salex1210/Project_Electronic_System_Design_B1/Capturas/MAP001.BMP

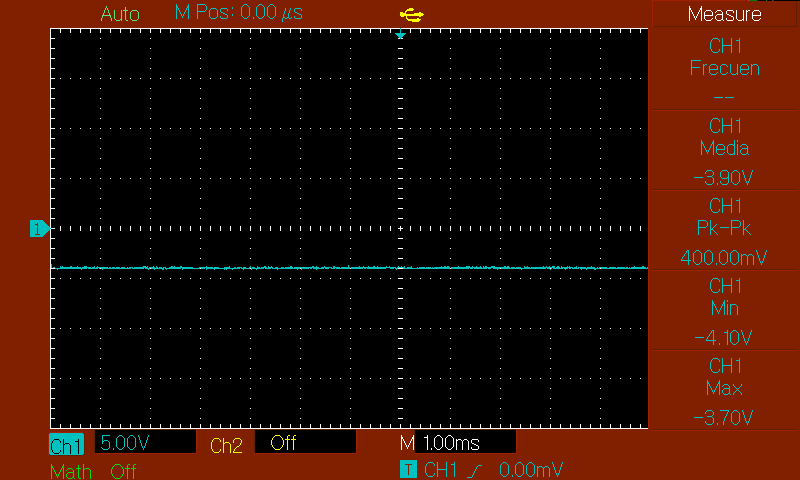
Capturas/MAP001.BMP
