salex1210/Project_Electronic_System_Design_B1/Capturas/MAP004.BMP

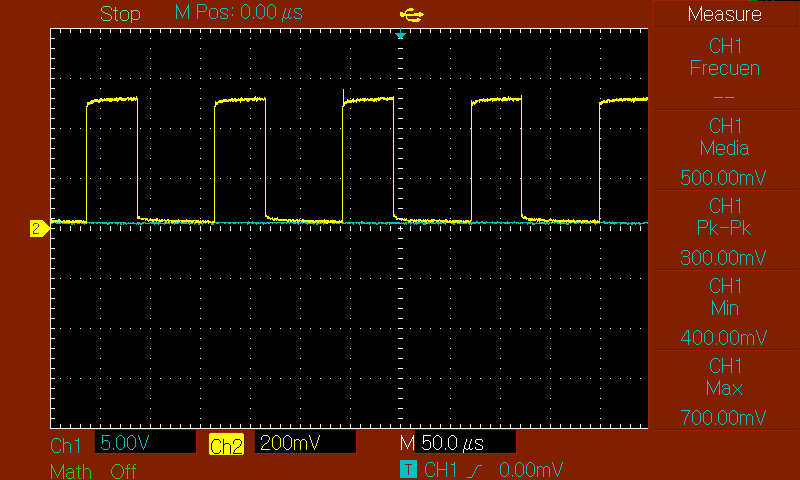
Capturas/MAP004.BMP
