salex1210/Project_Electronic_System_Design_B1/Capturas/MAP005.BMP

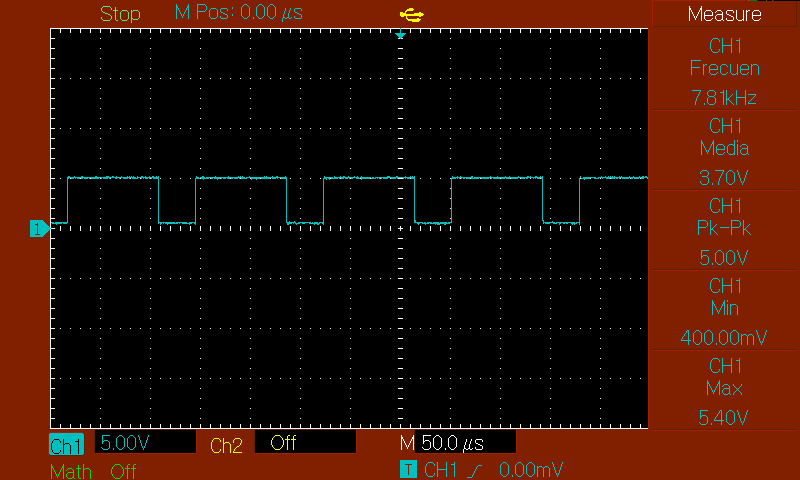
Capturas/MAP005.BMP
