salex1210/Project_Electronic_System_Design_B1/CuentasProyecto.xlsx

Sheet: Hoja1
 | Presupuesto Proyecto
 | Elemento | Unidades | Utilizados | Precio U. | Total Utilizados | Total Proyecto | Link
 | LTC2644IMS-L12#PBF | 2 | 1 | $33272.00 | $33272.00 | $66544.00 | https://co.mouser.com/ProductDetail/Analog-Devices/LTC2644IMS-L12PBF?qs=hVkxg5c3xu%252BwxghzaVh9wg%3D%3D
 | MAX1044/ICL7660 | 1 | 1 | $22045.00 | $22045.00 | $22045.00 | https://co.mouser.com/ProductDetail/Analog-Devices-Maxim-Integrated/MAX1044CPA%2b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
 | TL081HIDR | 4 | 2 | $1327.00 | $2654.00 | $5308.00 | https://co.mouser.com/ProductDetail/Texas-Instruments/TL081HIDR?qs=pBJMDPsKWf2IEA%252Bv86wIaw%3D%3D
 | Capacitor 0.1 uf X7R ceramico | 6 | 5 | $1633.00 | $8165.00 | $9798.00 | https://co.mouser.com/ProductDetail/KYOCERA-AVX/KAM21BR71H104JT?qs=Jm2GQyTW%2Fbic6Zk4McEt6w%3D%3D | https://co.mouser.com/ProductDetail/Vishay-Sprague/293D106X0016B2TE3
 | Capacitor 100 uf X7R | 4 | 2 | $2143.00 | $4286.00 | $8572.00 | https://co.mouser.com/ProductDetail/Vishay-Sprague/TR3B106K025C1300 | https://co.mouser.com/ProductDetail/TAIYO-YUDEN/EMK212BB7106KG-T
 | Header 1x2 | 5 | 4 | $2000.00 | $8000.00 | $10000.00
 | Jumper Cap | 5 | 4 | $1000.00 | $4000.00 | $5000.00
Bornera | Phoenix Contact 1729128 | 3 | 2 | $5000.00 | $10000.00 | $15000.00
 |  | 0 | 0 | $5000.00 | $0.00 | $0.00
 |  | 0 | 0 | $5000.00 | $0.00 | $0.00
 |  | 0 | 0 | $5000.00 | $0.00 | $0.00
 | Total |  |  |  | $92422.00 | $142267.00
 |  |  |  |  | $23105.50 | $35566.75

Sheet: Hoja1 (2)
Presupuesto Proyecto
Elemento | Unidades | Utilizados | Precio U. | Total Utilizados | Total Proyecto | Link
LTC2644IMS-L12#PBF | 2 | 1 | $33272.00 | $33272.00 | $66544.00 | https://co.mouser.com/ProductDetail/Analog-Devices/LTC2644IMS-L12PBF?qs=hVkxg5c3xu%252BwxghzaVh9wg%3D%3D
MAX1044/ICL7660 | 1 | 1 | $22045.00 | $22045.00 | $22045.00 | https://co.mouser.com/ProductDetail/Analog-Devices-Maxim-Integrated/MAX1044CPA%2b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
TL081HIDR | 2 | 1 | $1327.00 | $1327.00 | $2654.00 | https://co.mouser.com/ProductDetail/Texas-Instruments/TL081HIDR?qs=pBJMDPsKWf2IEA%252Bv86wIaw%3D%3D
MCP6002 | 2 | 1 | $1480.00 | $1480.00 | $2960.00 | https://co.mouser.com/ProductDetail/Microchip-Technology/MCP6002-I-SN?qs=cQYLKLPzRJlt69SDaZwGcA%3D%3D
Capacitor 0.1 uf | 5 | 4 | $1021.00 | $4084.00 | $5105.00 | https://co.mouser.com/ProductDetail/KYOCERA-AVX/KAM21BR71H104JT |  | https://co.mouser.com/ProductDetail/TAIYO-YUDEN/EMK212BB7106KG-T
Capacitor 100 uf | 3 | 2 | $2909.00 | $5818.00 | $8727.00 | https://co.mouser.com/ProductDetail/Murata-Electronics/GRM21BR60G107ME11L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
Header 1x2 | 5 | 4 | $510.00 | $2040.00 | $2550.00 | https://co.mouser.com/ProductDetail/Amphenol-FCI/10129379-902004BLF
Jumper Cap | 5 | 4 | $561.00 | $2244.00 | $2805.00 | https://co.mouser.com/ProductDetail/Harwin/M7583-46?qs=7s%252BXa3YB%252ByrDGEF4v%252ByEXg%3D%3D
Bornera | 2 | 2 | $1684.00 | $3368.00 | $3368.00 | https://co.mouser.com/ProductDetail/Amphenol-Anytek/TC0203620000G
Resistencia 20k | 0 | 0 | $1072.00 | $0.00 | $0.00 | https://co.mouser.com/ProductDetail/Panasonic/ERA-8AED203V?qs=MNPzkKEzRtRbjpUZ%2F2QFGA%3D%3D
Resistencia 10k | 8 | 6 | $510.00 | $3060.00 | $4080.00 | https://co.mouser.com/ProductDetail/YAGEO/RT1206FRD0710KL?qs=Fz%2FrpjPuTcHnXCbM3bUnCw%3D%3D
Resistencia 100 | 3 | 2 | $868.00 | $1736.00 | $2604.00 | https://co.mouser.com/ProductDetail/YAGEO/RT1206FRE07100RL?qs=8cPjvKtxWv7hPIhtALDV2w%3D%3D | https://co.mouser.com/ProductDetail/ROHM-Semiconductor/KTR18EZPJ101
Resistencia 15k | 2 | 1 | $500.00 | $500.00 | $1000.00 | https://co.mouser.com/ProductDetail/YAGEO/RT1206FRE0715KL?qs=fd0Ij%252BN8svyW6WTDZBxZXg%3D%3D
Resistencia 5K | 2 | 1 | $1582.00 | $1582.00 | $3164.00 | https://co.mouser.com/ProductDetail/YAGEO/RT1206BRD075KL?qs=8cPjvKtxWv5bP%252BIM%2FRQCeQ%3D%3D
 | 0 | 0 | $0.00 | $0.00 | $0.00
Total |  |  |  | $82556.00 | $127606.00
 |  |  |  | $20639.00 | $31901.50

Sheet: V3
Presupuesto Proyecto
Elemento |  | Utilizados | Precio U. | Total Utilizados | Total Proyecto | Link
LTC2644IMS-L12#PBF |  | 1 | $33450.00 | $33450.00 | $66900.00 | https://co.mouser.com/ProductDetail/Analog-Devices/LTC2644IMS-L12PBF?qs=hVkxg5c3xu%252BwxghzaVh9wg%3D%3D
MAX1044/ICL7660 |  | 1 | $20208.00 | $20208.00 | $40416.00 | https://co.mouser.com/ProductDetail/Analog-Devices-Maxim-Integrated/MAX1044CPA%2b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
TL081HIDR |  | 1 | $1327.00 | $1327.00 | $2654.00 | https://co.mouser.com/ProductDetail/Texas-Instruments/TL081HIDR?qs=pBJMDPsKWf2IEA%252Bv86wIaw%3D%3D
PS9851-1-F3-AX |  | 1 | $18116.00 | $18116.00 | $36232.00 | https://co.mouser.com/ProductDetail/Renesas-Electronics/PS9851-1-F3-AX?qs=CN%252BGnklfK0oKU9JkAbHdMA%3D%3D
Capacitor 0.1 uf |  | 2 | $1021.00 | $2042.00 | $3063.00 | https://co.mouser.com/ProductDetail/KYOCERA-AVX/KAM21BR71H104JT | https://co.mouser.com/ProductDetail/TAIYO-YUDEN/EMK212BB7106KG-T
Capacitor 100 uf |  | 2 | $2909.00 | $5818.00 | $8727.00 | https://co.mouser.com/ProductDetail/Murata-Electronics/GRM21BR60G107ME11L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
Header 1x2 |  | 7 | $510.00 | $3570.00 | $3060.00 | https://co.mouser.com/ProductDetail/Amphenol-FCI/10129379-902004BLF
Jumper Cap |  | 5 | $561.00 | $2805.00 | $3366.00 | https://co.mouser.com/ProductDetail/Harwin/M7583-46?qs=7s%252BXa3YB%252ByrDGEF4v%252ByEXg%3D%3D
Bornera |  | 2 | $1684.00 | $3368.00 | $3368.00 | https://co.mouser.com/ProductDetail/Amphenol-Anytek/TC0203620000G
Resistencia 10k |  | 5 | $510.00 | $2550.00 | $3060.00 | https://co.mouser.com/ProductDetail/YAGEO/RT1206FRD0710KL?qs=Fz%2FrpjPuTcHnXCbM3bUnCw%3D%3D
Total |  |  |  | $93254.00 | $170846.00
Enviado | $82000.00 | Pendiente |  | $11254.00 | $2813.50 | https://co.mouser.com/ProductDetail/YAGEO/RT1206FRE0715KL?qs=fd0Ij%252BN8svyW6WTDZBxZXg%3D%3D
Envio |  |  |  | $250000.00 | $0.00
grupos |  | 7 |  | $35714.29 | $0.00
Total Con Envio |  |  |  | $46968.29
Total Pendiente por miembro |  |  |  | $11742.07
