salex1210/Project_Electronic_System_Design_B1/(list of files, drawings)

Other design files:
Project Backups/diseno_project [20250427, 16-17-39].pdsprj
Project Backups/diseno_project [20250427, 16-19-24].pdsprj
Project Backups/diseno_project [20250427, 21-24-25].pdsprj
Project Backups/diseno_project [20250529, 11-37-57].pdsprj
