salex1210/Project_Electronic_System_Design_B1/(commit log)

2025-04-04 regukador de voltaje
2025-04-17 til082 dual
    [diseno_project [20250407, 22-31-02].pdsprj]
2025-04-17 dual voltage
2025-04-22 grafica actualizada con 300 muestras
    [diseno_project [20250407, 22-31-02].pdsprj]
2025-04-28 resultado circuitos y graficas
    [diseno_project [20250427, 16-17-39].pdsprj, diseno_project [20250427, 16-19-24].pdsprj, diseno_project [20250427, 21-24-25].pdsprj, diseno_project.pdsprj]
2025-06-05 muestras y pruebas con la esp32
    [CuentasProyecto.xlsx, diseno_project [20250529, 11-37-57].pdsprj]
